gxk2000/GameShell_Joypad/demo/IMG_20230120_122651.jpg

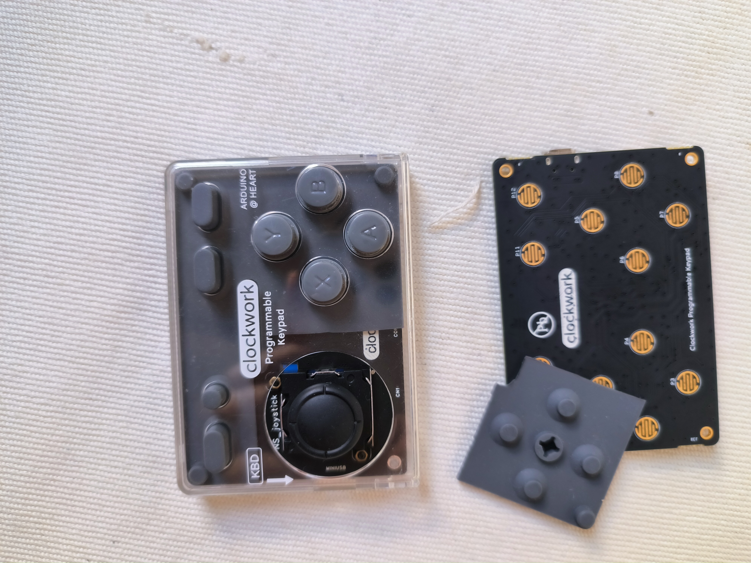
demo/IMG_20230120_122651.jpg
