gxk2000/GameShell_Joypad/demo/IMG_20230116_065845.jpg

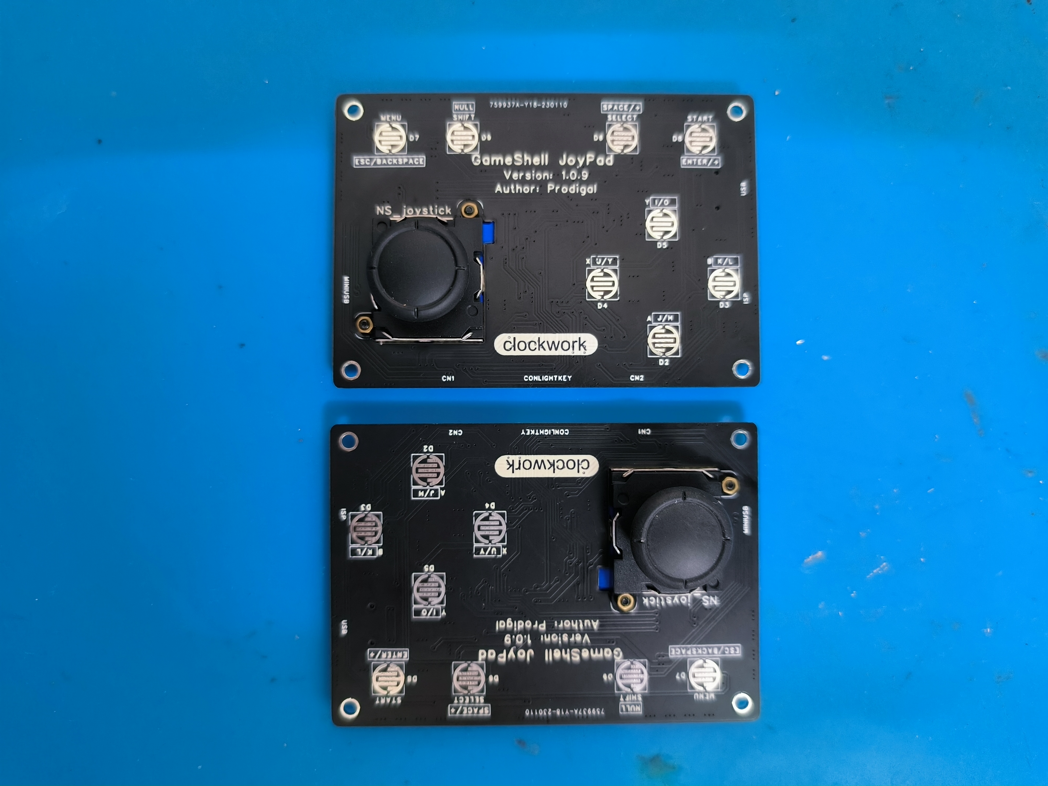
demo/IMG_20230116_065845.jpg
