gxk2000/GameShell_Joypad/demo/IMG_20230117_171947.jpg

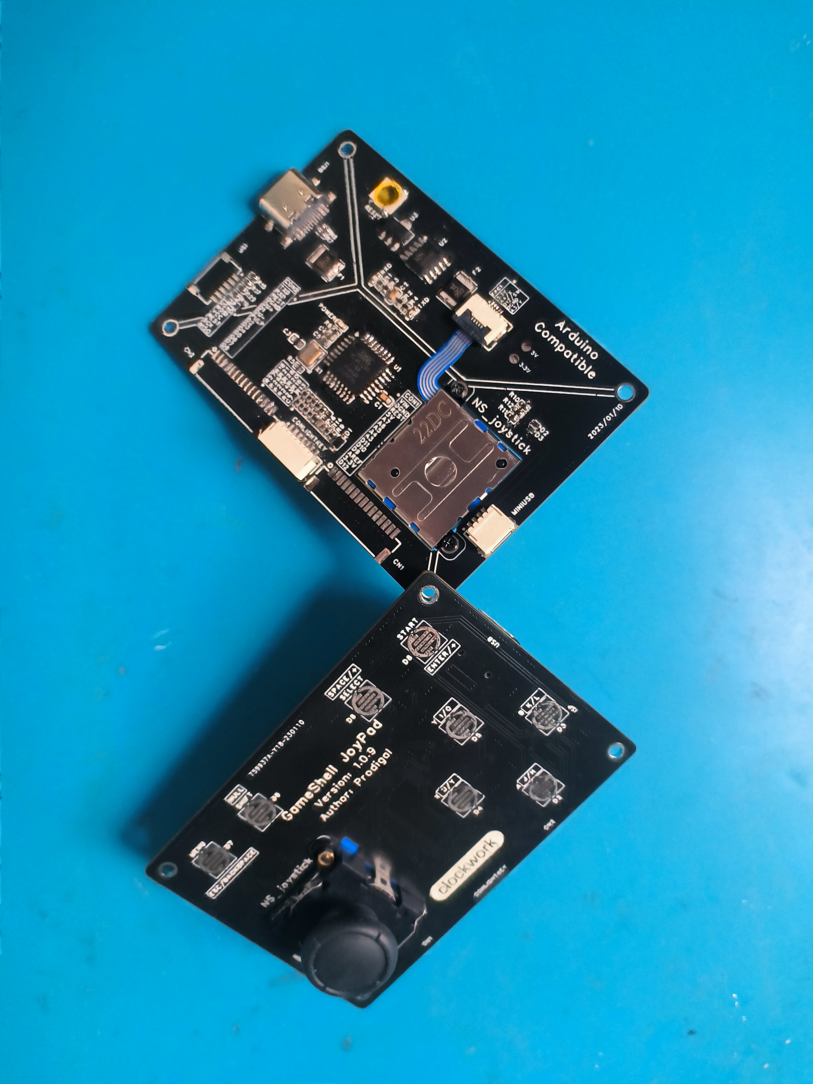
demo/IMG_20230117_171947.jpg
