gxk2000/GameShell_Joypad/pcb/BOM_Board1_Schematic_1.1.0.xlsx

No. | 名称 | 封装 | 值 | 数量 | 位号
1 | ATMEGA328P-AU | TQFP-32_L7.0-W7.0-P0.80-LS9.0-BL |  | 1 | U1
2 | CH340K | ESOP-10_L4.9-W3.9-P1.00-LS6.2-BL-EP |  | 1 | U2
3 | DF2S6.8FS | SOD-923_L0.8-W0.6-LS1.0-RD-1 |  | 2 | D2,D3
4 | 四脚贴片晶振 | OSC-SMD_4P-L3.2-W2.5-BL | 16MHz | 1 | X1
5 | SMD1812P050TF | F1812 |  | 2 | F1,F2
6 | AMS1117-5.0 | SOT-89-3_L4.5-W2.5-P1.50-LS4.2-BR |  | 1 | U3
7 | SD101CWS/SD101AWS | SOD-323_L1.7-W1.3-LS2.5-RD |  | 1 | D1
8 | 贴片薄膜开关 | SW-SMD_4P-L4.5-W4.5-P3.50-LS5.0 |  | 1 | SW1
9 | Type-C母口座子 | USB-C-SMD_TYPEC-304S-ACP16 |  | 1 | USB1
10 | 贴片电阻 | R0402 | 1k | 5 | R1,R2,R3,R4,R8
11 | 贴片电阻 | R0402 | NA | 2 | R5,R13
12 | 贴片电阻 | R0402 | 10k | 15 | R9,R15,R16,R17,R18,R19,R20,R21,R22,R23,R24,R25,R26,R27,R28
13 | 贴片电阻 | R0402 | 1.5K | 1 | R12
14 | 贴片电阻 | R0402 | 22R | 4 | R6,R7,R10,R11
15 | 贴片电阻 | R0402 | 0R | 1 | R14
16 | 贴片电容 | R0402 | 10uf | 2 | C5,C7
17 | 贴片电容 | C0603 | 100nf | 3 | C1,C2
18 | 贴片电容 | C0603 | NA | 1 | C3
19 | 贴片电容 | R0402 | 100nf | 2 | C4,C6
20 | 贴片LED | LED0402-RD |  | 2 | LED1,LED2,LED3
21 | FPC接口下翻盖0.5mm | FPC-SMD_5P-P0.50_HDGC_0.5K-DX-5PWB |  | 1 | FPC1
22 | sh1.0mm 15pin | CONN-SMD_15P-P1.00_HCTL_HC-1.0-15PWT |  | 2 | CN2,CN3
23 | sh1.0mm 6pin | CONN-SMD_6P-P1.00_HDGC_1.0K-BH-6PWB |  | 1 | CN4
24 | sh1.0mm 4pin | CONN-SMD_4P-P1.00_HDGC_1.0K-BH-4PWB |  | 1 | CN1
25 | sh1.0mm 7pin | CONN-SMD_7P-P1.00_HDGC_HDGC1002WR-S-7P |  | 1 | CONLIGHTKEY
26 | M1.4铜螺母 |  |  | 2
27 | M1.4*3碳钢十字扁平头螺钉 |  |  | 2
28 | switch国产摇杆 |  |  | 1
