gxk2000/GameShell_Joypad/pcb/joypad_1.1.0.pdf

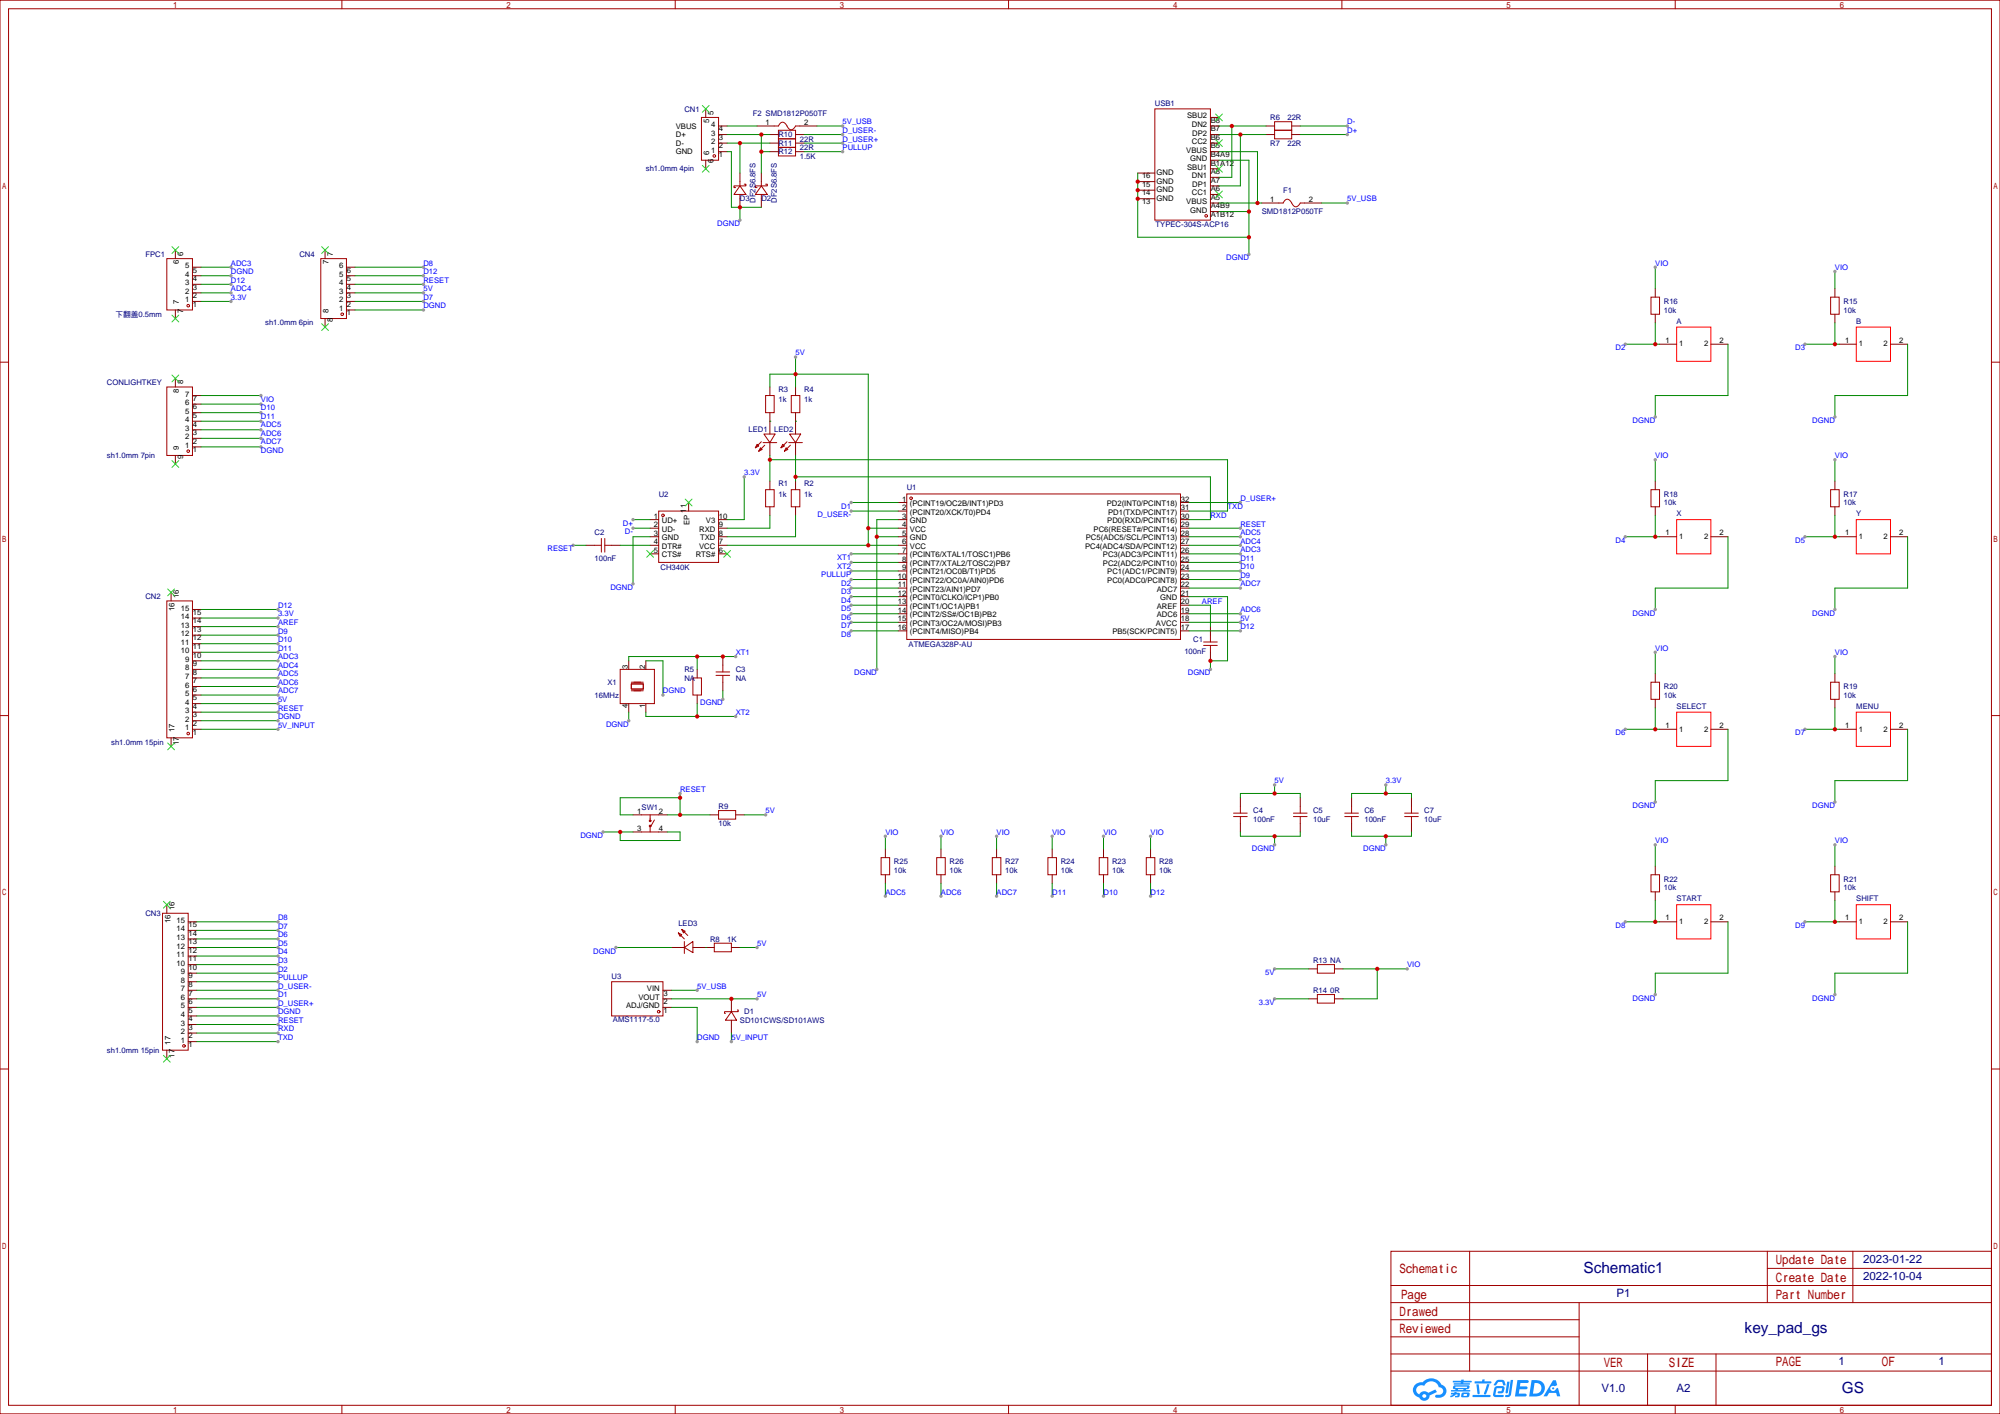
[picture p6: page 1]
